jbattat/RTD_Readout_8chan/images/PCB_Layout.png

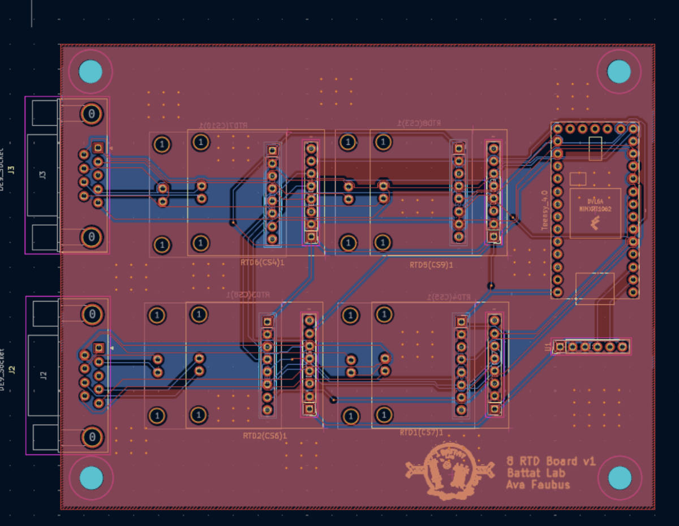
images/PCB_Layout.png
