jbattat/RTD_Readout_8chan/images/PopulatedPCBFront.png

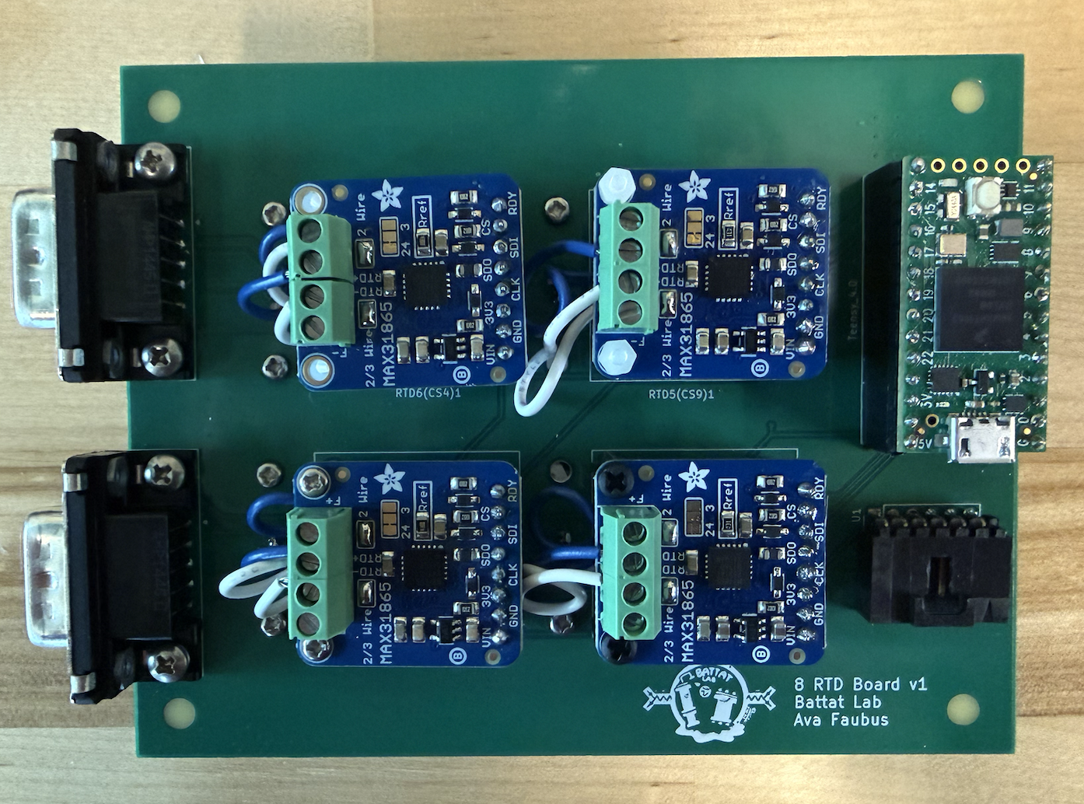
images/PopulatedPCBFront.png
