jbattat/RTD_Readout_8chan/Hardware/bom.md

# Bill of Materials

| Item | Qty | Description | Vendor | Part Number | Link |
| :--- | :--- | :--- | :--- | :--- | :--- |
| 1 | 1 | 8 RTD Board PCB | --- | --- | [Fab Files](/Hardware/PCB%20v2/Fab%20Files) | 
| 2 | 1 | RS232/RS485 to Ethernet Converter | Waveshare | RS232/485 TO ETH | [Waveshare](https://www.waveshare.com/rs232-485-to-eth.htm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) | 
| 3 | 1 | MAX3232 Serial Port To TTL Converter Module | --- | 717066057519 | [Serial to TTL Converter](https://www.amazon.com/MAX3232-Serial-Converter-Module-Connector/dp/B07VL7GNG3) | 
| 4 | 1 | 6 pin connector | Molex | --- | --- | 
| 5 | 8 | PT100 RTD Temperature Sensor Amplifier MAX31865 | Adafruit | P3328D | [RTD](https://www.adafruit.com/product/3328?srsltid=AfmBOooz6lJhAuu2JRmIFAE9JG9DHEwayJ1r29LPcVYMyzHe-qnFpfGa) | 
| 6 | 1 | Teensy 4.0 | SparkFun | DEV-15583 | [Teensy 4.0](https://www.sparkfun.com/teensy-4-0.html) | 
| 7 | 8 | RTD PT100 | DigiKey | 223-1822-ND | [RTD PT100](https://www.digikey.com/en/products/detail/te-connectivity-measurement-specialties/nb-ptco-381/7261461) | 
| 8 | 2 | D9 Male PCB Mount Connector | DigiKey | 19-88609-5005-ND | [D9 PCB mount](https://www.digikey.com/en/products/detail/3m/88609-5005/22162224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) | 
| 9 | 1 | Panel Mount DC Barrel Jack | Adafruit | 163-4302-E | [DC barrel jack](https://www.sparkfun.com/dc-barrel-power-jack-connector.html) | 
| 10 | 1 | 5V Wall Power Supply | --- | --- | --- | 
| 11 | 1 | Metal box (modified with cutouts for jack and D9s) | BUD Industries | CU-471-ND | [Box](https://www.digikey.com/en/products/detail/bud-industries/CU-471/439262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) | 
| 12 | 6 |  Wires | --- | --- | --- |
