jbattat/RTD_Readout_8chan/(commit log)

2026-05-28 Create BOM
2026-05-28 Update BOM
